selprom/kicad-library/3d modelos/br7/Source/15EDGRC-3.5.SLDASM

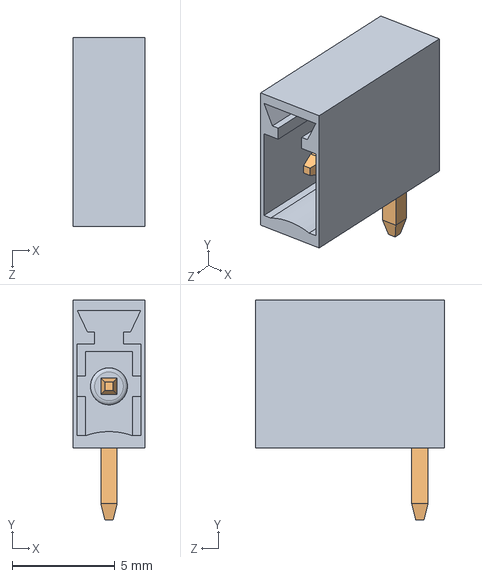
[picture p1: CAD file, 2020-07-04]
3d modelos/br7/Source/15EDGRC-3.5.SLDASM
3.50 x 10.7 x 9.20 mm
15EDGRC-3.5
15EDGRC-3.5-PIN
