selprom/kicad-library/3d modelos/chaveAL90.STEP

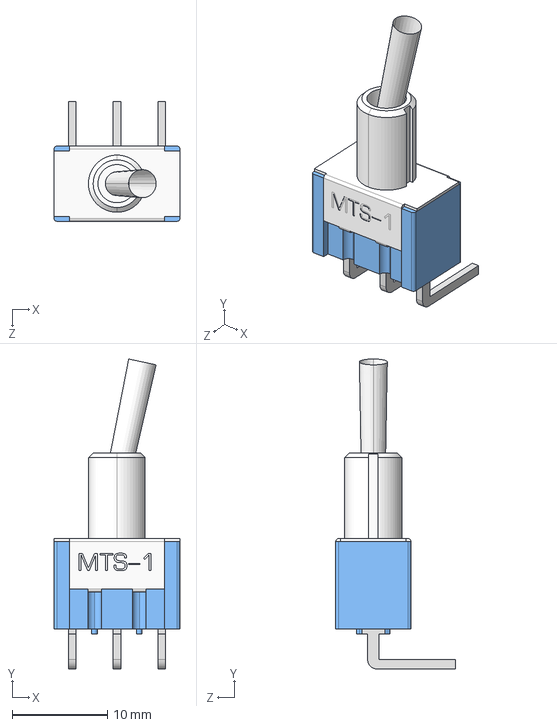
[picture p2: CAD file, 2020-07-04]
3d modelos/chaveAL90.STEP
13.2 x 32.5 x 12.5 mm
