selprom/kicad-library/3d modelos/br7/Source/15EDGRC-3.5-thickening.sldprt

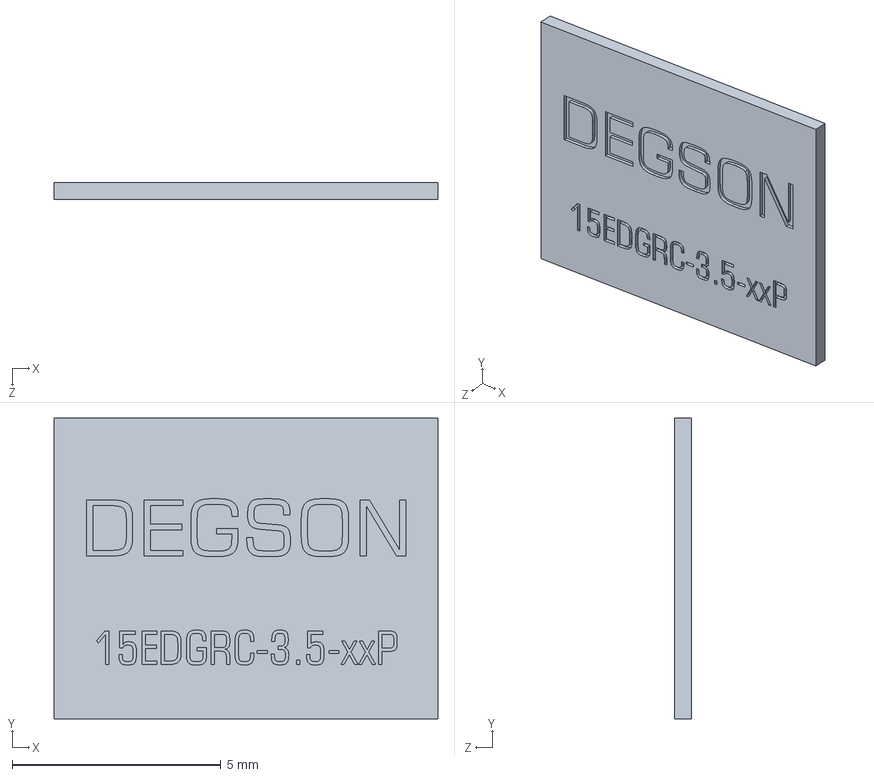
[picture p3: CAD file, 2020-07-04]
3d modelos/br7/Source/15EDGRC-3.5-thickening.sldprt
9.20 x 7.20 x 0.4 mm
