selprom/kicad-library/3d modelos/con_bat-60A.STEP

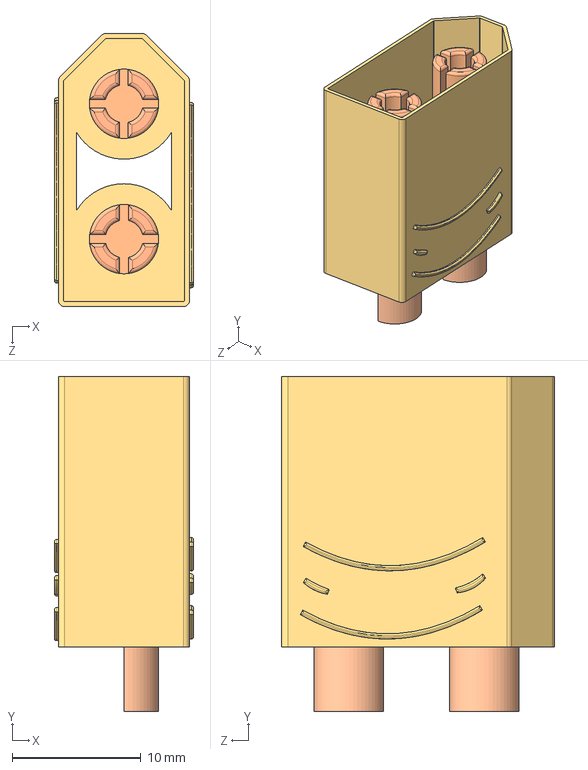
[picture p4: CAD file, 2020-07-04]
3d modelos/con_bat-60A.STEP
10.8 x 26.0 x 21.2 mm
