selprom/kicad-library/3d modelos/br7/Source/15EDGRC-3.5-PIN.sldprt

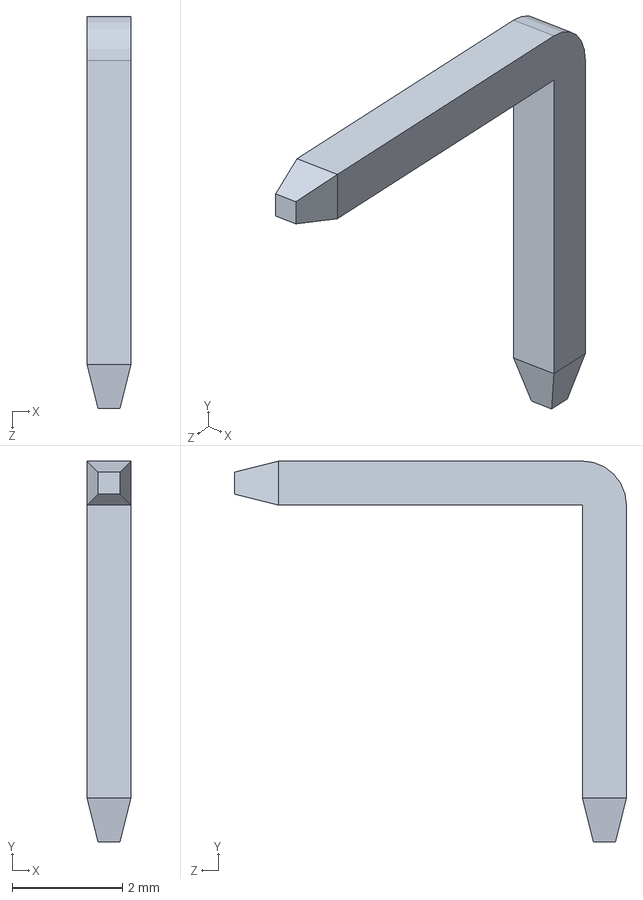
[picture p5: CAD file, 2020-07-04]
3d modelos/br7/Source/15EDGRC-3.5-PIN.sldprt
0.8 x 6.90 x 7.10 mm
