selprom/kicad-library/3d modelos/br8-2.STEP

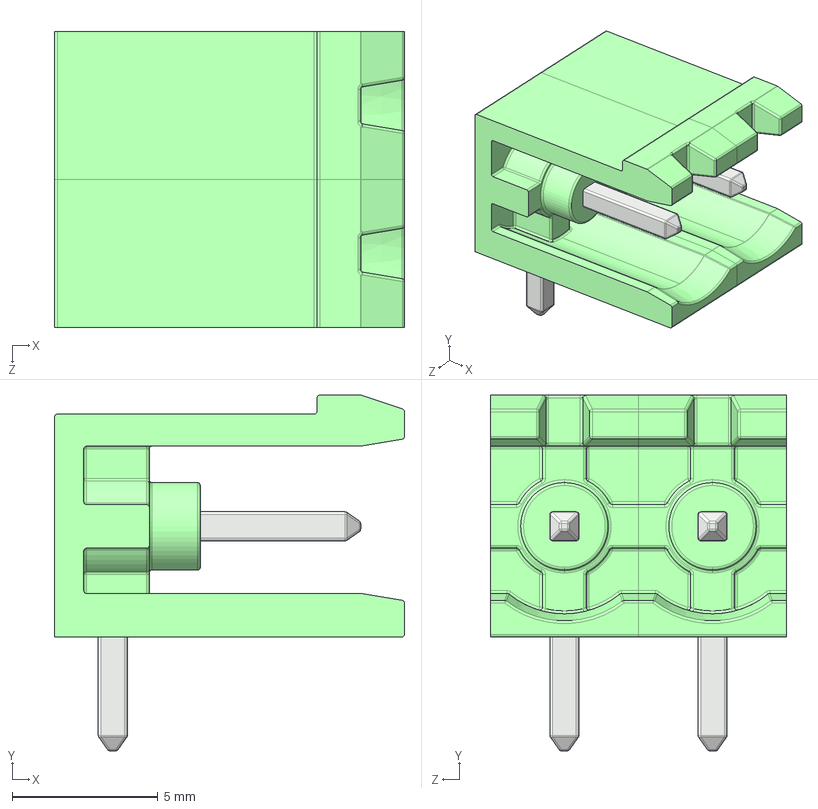
[picture p6: CAD file, 2020-07-04]
3d modelos/br8-2.STEP
12.0 x 12.2 x 10.2 mm
