selprom/kicad-library/3d modelos/tomada.STEP

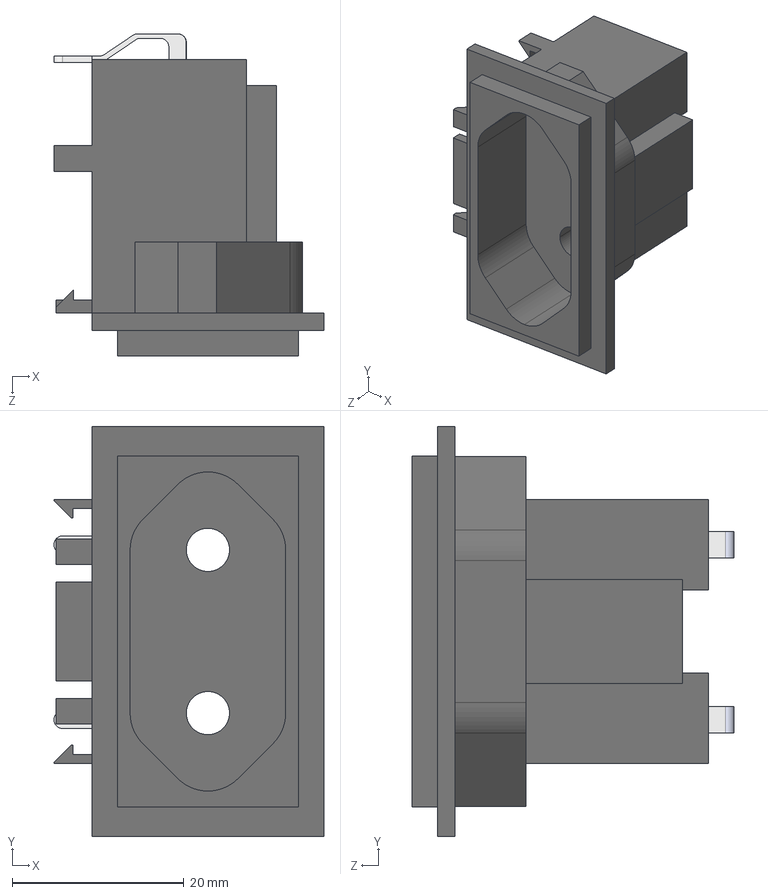
[picture p7: CAD file, 2020-07-04]
3d modelos/tomada.STEP
31.4 x 47.7 x 37.5 mm
