selprom/kicad-library/3d modelos/con_din_48_m.STEP

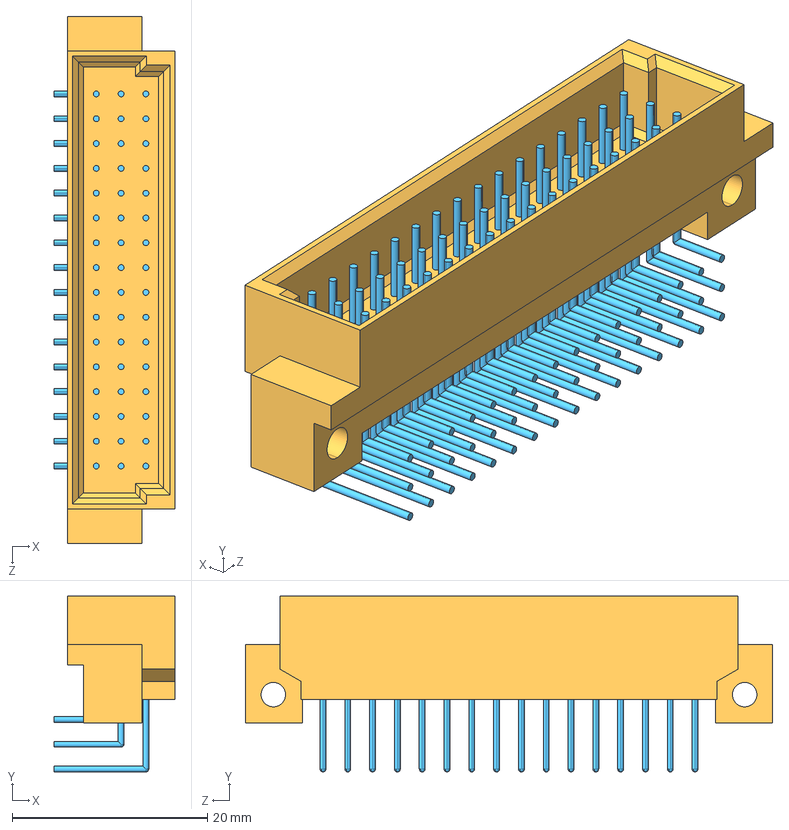
[picture p8: CAD file, 2020-07-04]
3d modelos/con_din_48_m.STEP
12.4 x 18.0 x 54.0 mm
