selprom/kicad-library/3d modelos/br8-4.STEP

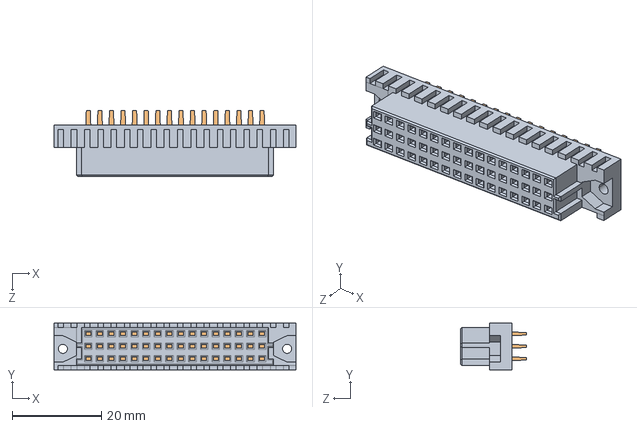
[picture p9: CAD file, 2020-07-04]
3d modelos/br8-4.STEP
54.3 x 10.5 x 14.8 mm
