selprom/kicad-library/3d modelos/led_dual-90.STEP

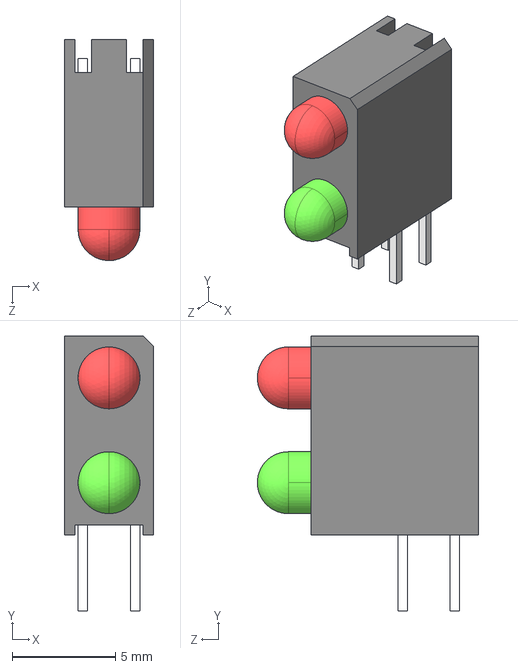
[picture p10: CAD file, 2020-07-04]
3d modelos/led_dual-90.STEP
4.32 x 13.3 x 10.7 mm
