selprom/kicad-library/3d modelos/dis_ups.STEP

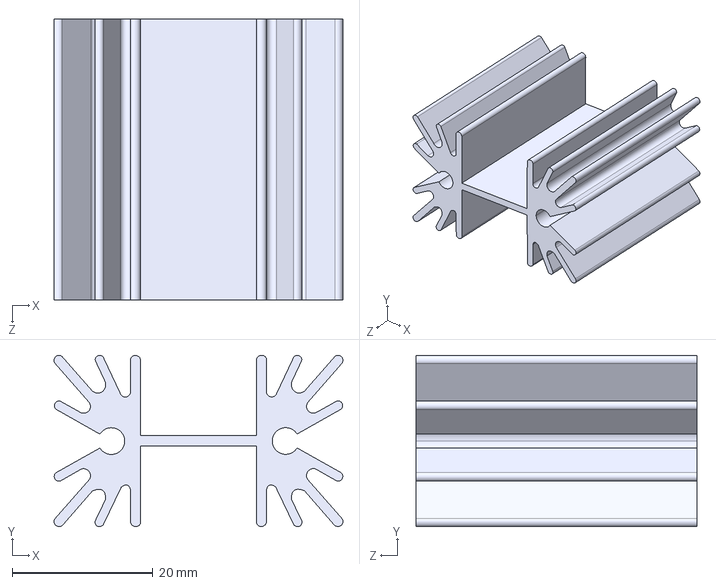
[picture p11: CAD file, 2020-07-04]
3d modelos/dis_ups.STEP
41.1 x 24.4 x 40.0 mm
