selprom/kicad-library/3d modelos/conn_dim_64.STEP

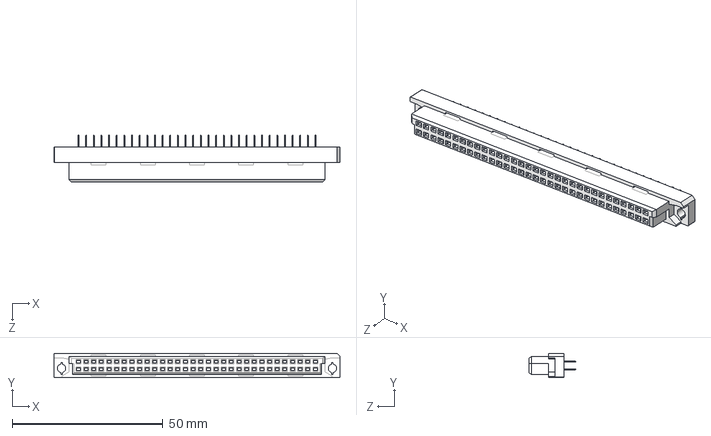
[picture p12: CAD file, 2020-07-04]
3d modelos/conn_dim_64.STEP
95.0 x 8.10 x 15.6 mm
