selprom/kicad-library/3d modelos/br8-3.STEP

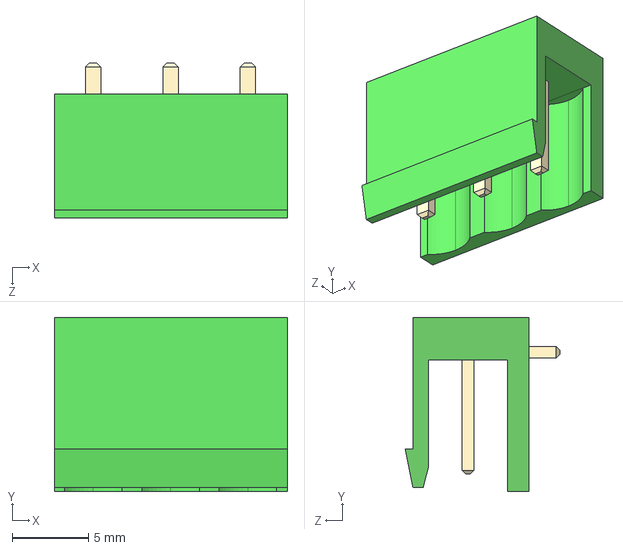
[picture p13: CAD file, 2020-07-04]
3d modelos/br8-3.STEP
15.3 x 11.4 x 10.2 mm
