selprom/kicad-library/3d modelos/fuse_vdr-mar.STEP

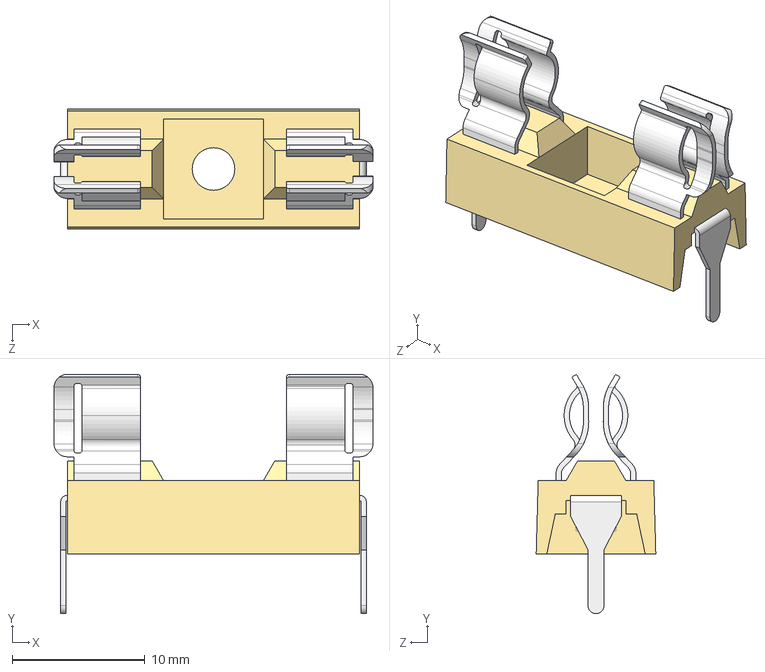
[picture p14: CAD file, 2020-07-04]
3d modelos/fuse_vdr-mar.STEP
24.0 x 18.0 x 9.00 mm
