selprom/kicad-library/3d modelos/POT_MV.STEP

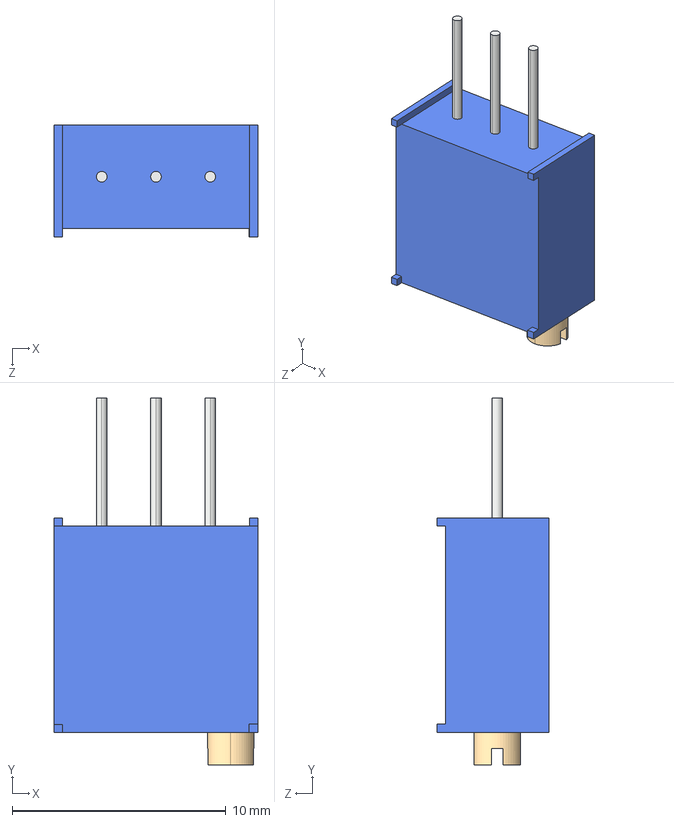
[picture p15: CAD file, 2020-07-04]
3d modelos/POT_MV.STEP
9.52 x 17.2 x 5.23 mm
