selprom/kicad-library/3d modelos/conector48M.STEP

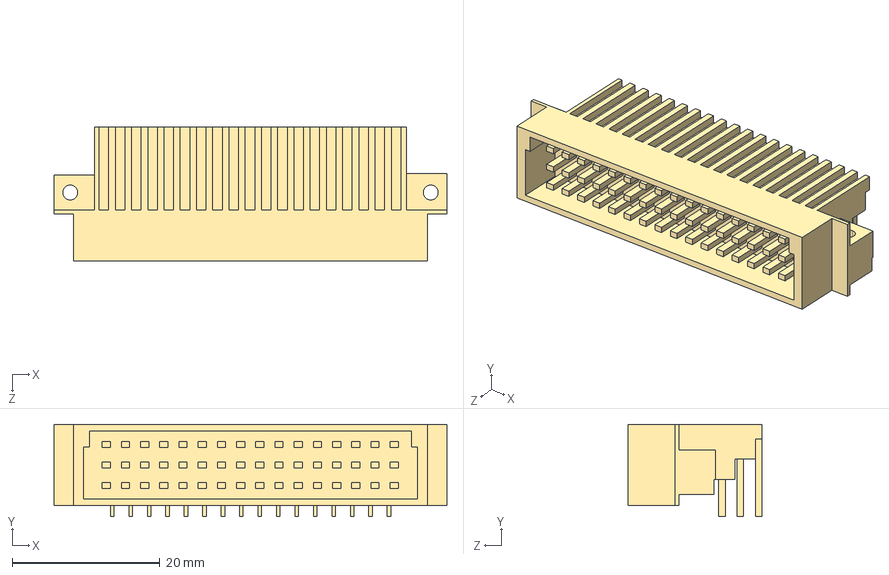
[picture p16: CAD file, 2020-07-04]
3d modelos/conector48M.STEP
53.2 x 12.5 x 18.2 mm
