selprom/kicad-library/3d modelos/chave_KDCA11.STEP

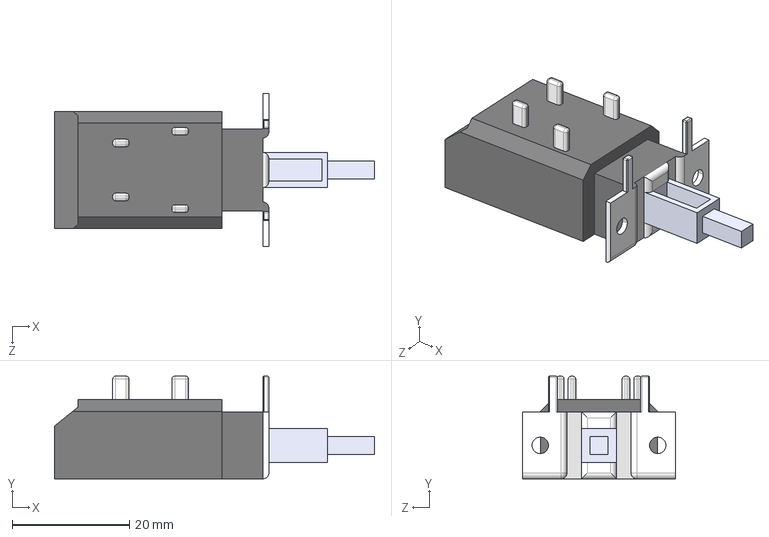
[picture p17: CAD file, 2020-07-04]
3d modelos/chave_KDCA11.STEP
54.5 x 17.5 x 26.0 mm
