selprom/kicad-library/3d modelos/fusivel_rosca.STEP

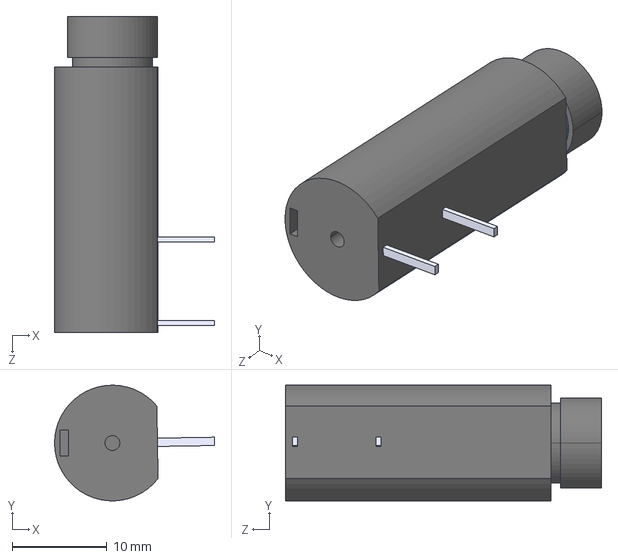
[picture p18: CAD file, 2020-07-04]
3d modelos/fusivel_rosca.STEP
16.9 x 12.2 x 33.3 mm
