selprom/kicad-library/3d modelos/trafo_12_pci.STEP

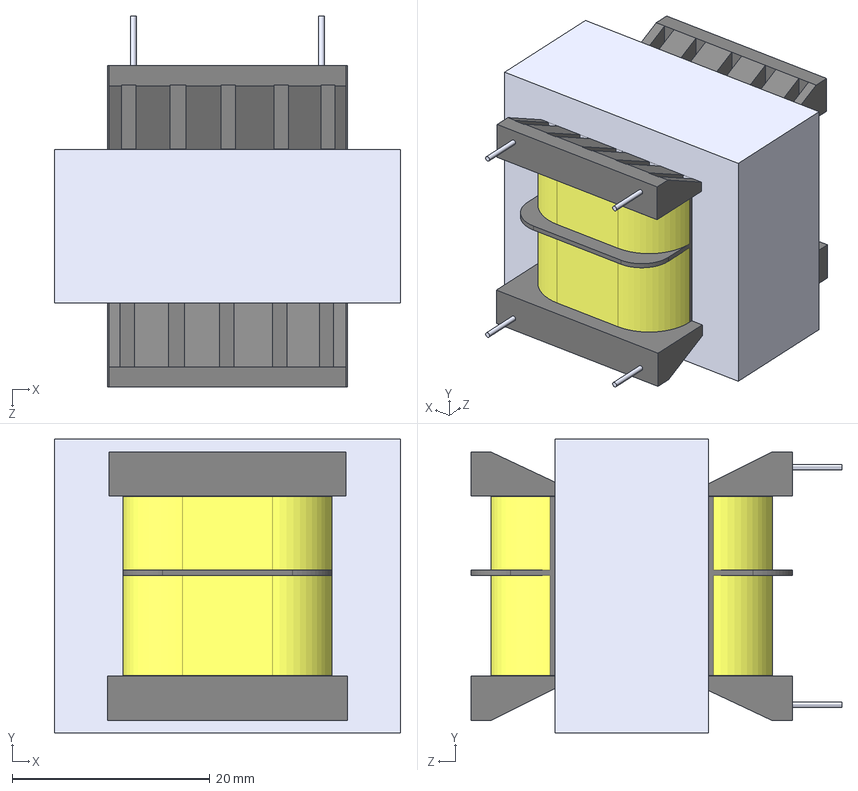
[picture p19: CAD file, 2020-07-04]
3d modelos/trafo_12_pci.STEP
35.0 x 29.7 x 37.5 mm
