selprom/kicad-library/3d modelos/con_8.STEP

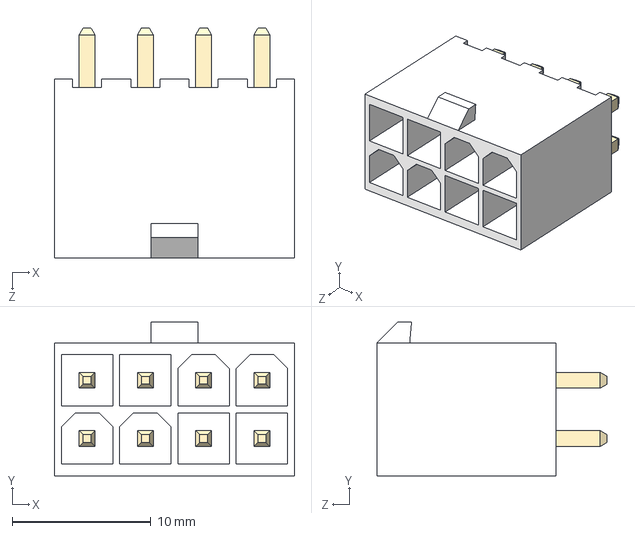
[picture p20: CAD file, 2020-07-04]
3d modelos/con_8.STEP
17.3 x 11.1 x 16.6 mm
