selprom/kicad-library/3d modelos/ESP32.STEP

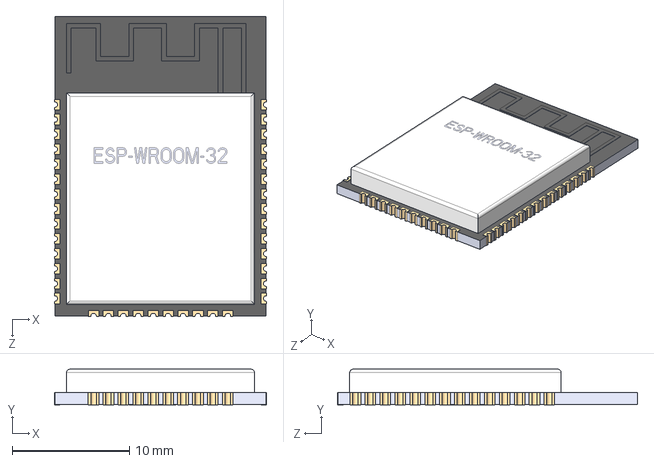
[picture p21: CAD file, 2020-07-04]
3d modelos/ESP32.STEP
18.1 x 3.04 x 25.5 mm
