selprom/kicad-library/3d modelos/con_din_48_f.STEP

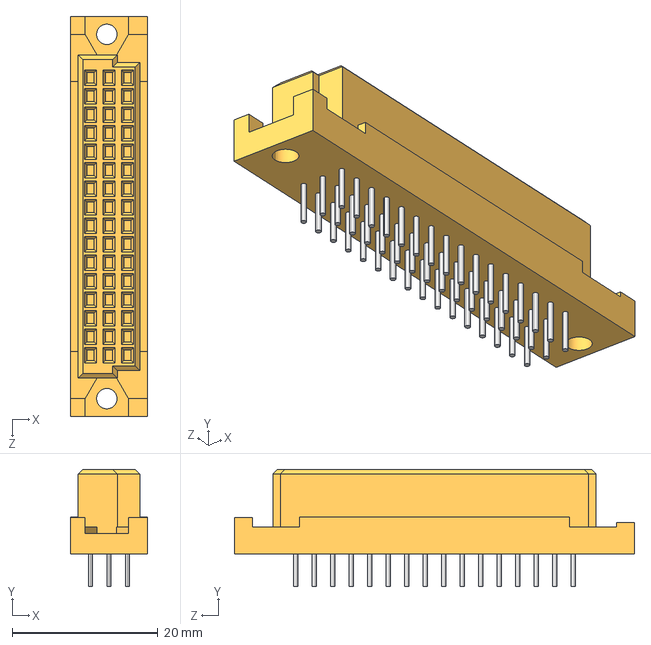
[picture p22: CAD file, 2020-07-04]
3d modelos/con_din_48_f.STEP
10.5 x 16.1 x 54.9 mm
