selprom/kicad-library/3d modelos/led_90_vm.STEP

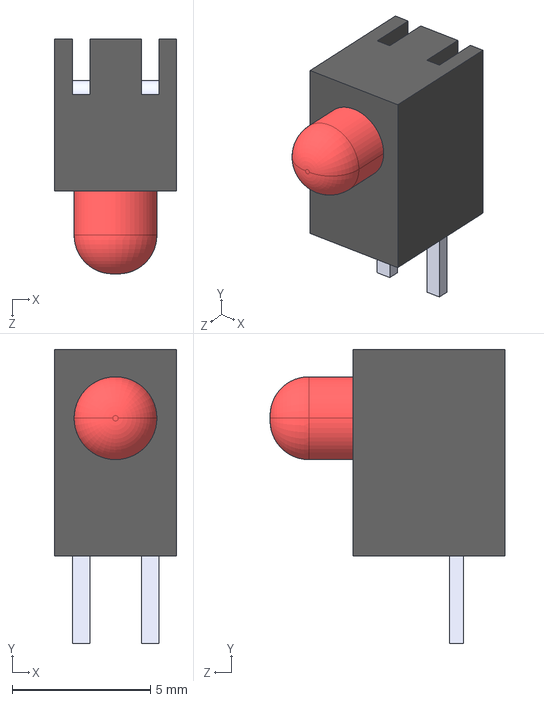
[picture p23: CAD file, 2020-07-04]
3d modelos/led_90_vm.STEP
4.42 x 10.6 x 8.50 mm
