selprom/kicad-library/3d modelos/RELAY-RT1-30-A.STEP

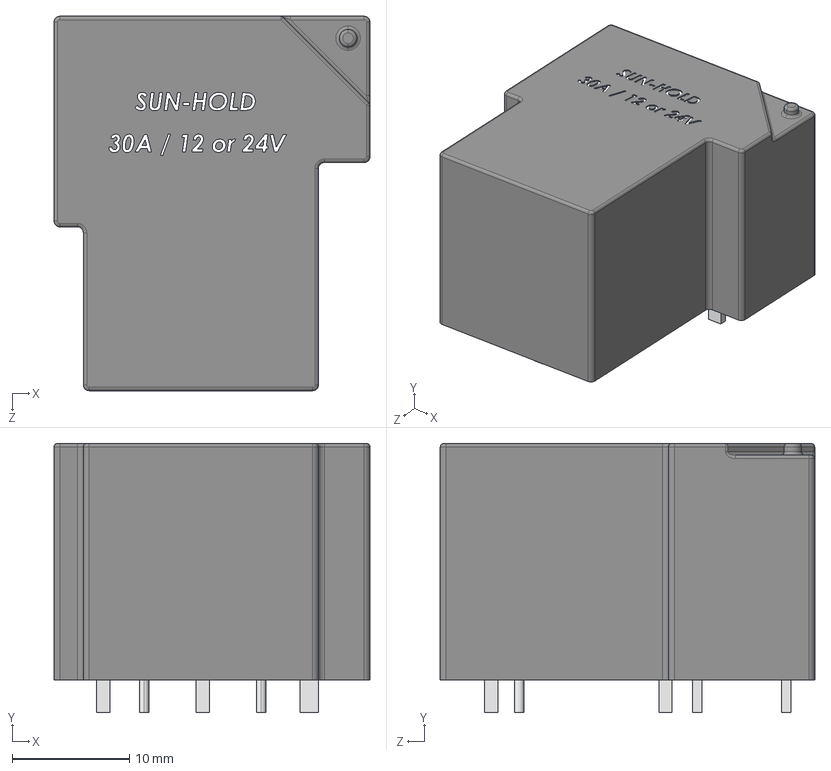
[picture p24: CAD file, 2020-07-04]
3d modelos/RELAY-RT1-30-A.STEP
27.0 x 23.0 x 32.0 mm
