selprom/kicad-library/3d modelos/botao_rst-90.STEP

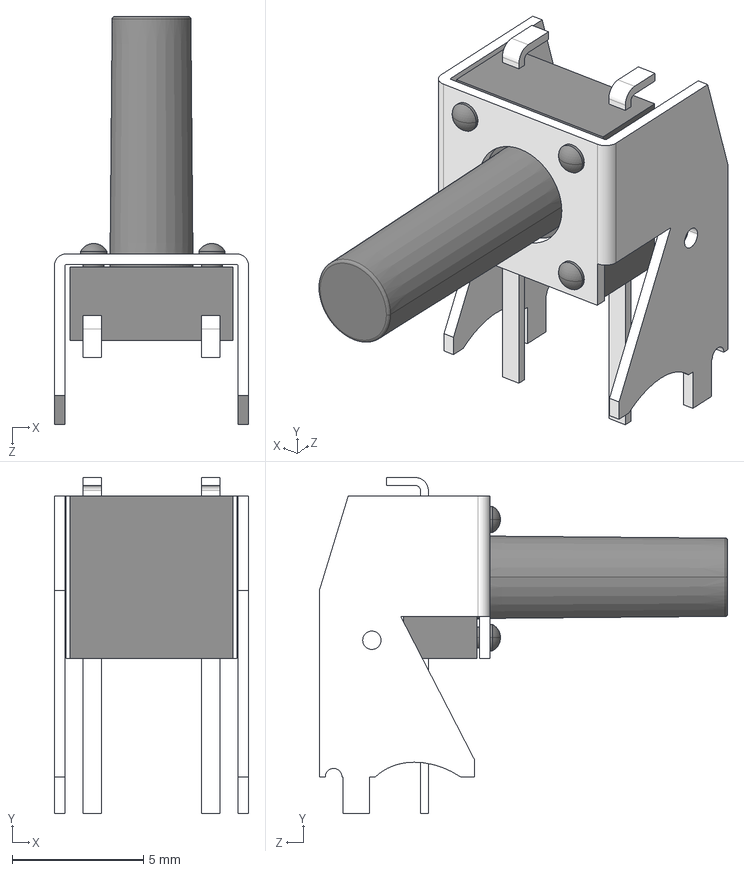
[picture p25: CAD file, 2020-07-04]
3d modelos/botao_rst-90.STEP
7.40 x 12.8 x 15.6 mm
