selprom/kicad-library/3d modelos/fuse_vdr-preto.STEP

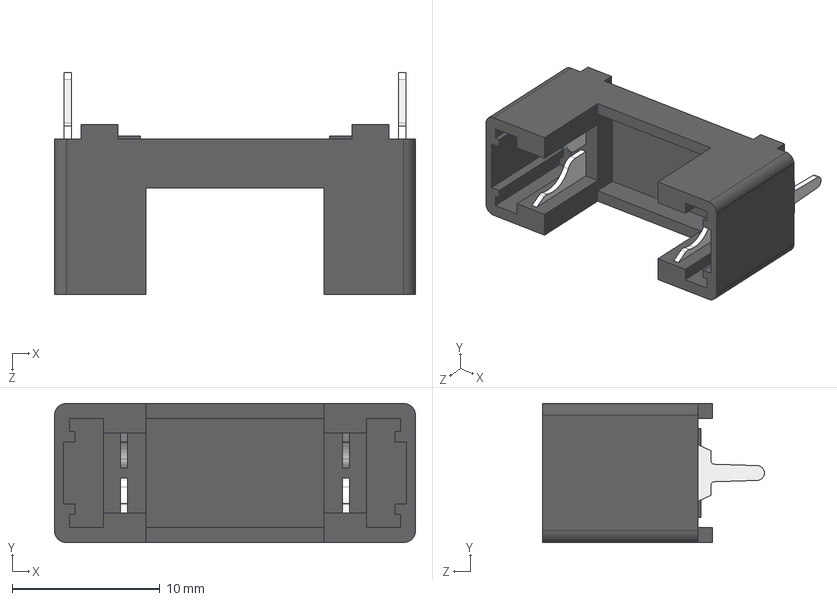
[picture p26: CAD file, 2020-07-04]
3d modelos/fuse_vdr-preto.STEP
24.4 x 9.40 x 15.0 mm
