selprom/kicad-library/(list of files, cad)

Other CAD files:
3d modelos/com_dim-48.STEP
3d modelos/br7/Source/15EDGRC-3.5.sldprt
3d modelos/br8-4 (2).STEP
